aghasalim/smart-ivc-cage-platform/docs/architecture-overview.pdf

# IVC Cage — Technical Architecture

How the components connect: Cage hardware → Arduino Mega → Raspberry Pi 5 (self-hosted) → Cloudflare Tunnel → Web dashboard

CAGE HARDWARE | MICROCONTROLLER | EDGE HOST — RASPBERRY PI 5 | CLOUD · USERS · CI

### SENSORS → Mega pins

HX711 ×3 — load cells
food D4/5 · water D6/7 · mouse D8/9

DHT11 temp/humidity — D3

YF-S401 water flow — D2 (int)

MH-Z19C CO₂ — UART Serial3

### ACTUATORS ← Mega pins

Food-gate servo — D11

Water pump (relay) — D12

Solenoid valve (relay) — D13

### USB → PI (not via Mega)

O₂ sensor JXW-02
USB-CH340 → /dev/ttyUSB

USB cameras ×3
powered hub → V4L2 (MJPEG)

12 V supply → pump/valve;

### 5 V → Mega & sensors

## Arduino Mega

2560

reads all sensors
drives actuators
closed-loop dosing
+ flow calibration
feeding-gate logic

JSON over USB serial
115200 baud · every 5 s

## systemd services (no Docker) — hosts the whole stack

### ivc-arduino-bridge

USB serial ↔ Arduino · threaded poster · relays commands

### ivc-backend — FastAPI (:8000)

REST API + WebSocket · serves the React SPA AI: behaviour classifier + anomaly detector feeding scheduler → opens/closes gate on time SQLite (WAL) — local DB

### ivc-cameras (:8090)

V4L2 → MJPEG streams · snapshots · 16 camera controls · relays servo/pump cmds to the bridge

ivc-env-ingester
DHT11 → backend

ivc-inference
on-Pi YOLO detector

cloudflared
outbound tunnel
(no inbound ports)

pi-deploy.timer
polls GitHub 60 s →
rebuild + restart

Ingest: bridge → POST /api/v1/ingest → SQLite → WebSocket fan-out Commands: dashboard → backend/cameras → /tmp queue → bridge → Arduino

USB JSON

### Cloudflare

Tunnel + DNS/TLS
favatis.com · cam.favatis.com

### Web dashboard

React + Vite SPA
8 sections · 4 languages
live charts · camera control researcher in any browser / PWA

### GitHub repo

push to main →
auto-deploy to Pi

Google Colab
YOLO training (optional)

encrypted outbound

HTTPS / WSS

git push → 60 s poll → rebuild & restart

### Data & control flows

Sensors → Arduino (analog/digital/UART) and Arduino → actuators

Arduino ↔ Pi bridge over USB serial (JSON readings up; servo/pump/dose commands down)

USB sensors/cameras → Pi · and Pi ↔ browser via Cloudflare (HTTPS REST + live WebSocket)

Deploy loop: GitHub push → pi-deploy pulls every 60 s → rebuilds & restarts only changed services

Self-hosted on the Raspberry Pi 5 · exposed only through an outbound Cloudflare Tunnel (zero open inbound ports) · no Vercel/Railway.
