aghasalim/smart-ivc-cage-platform/ai/reports/behavioral_monitoring/outputs/plots/activity_rhythm.png

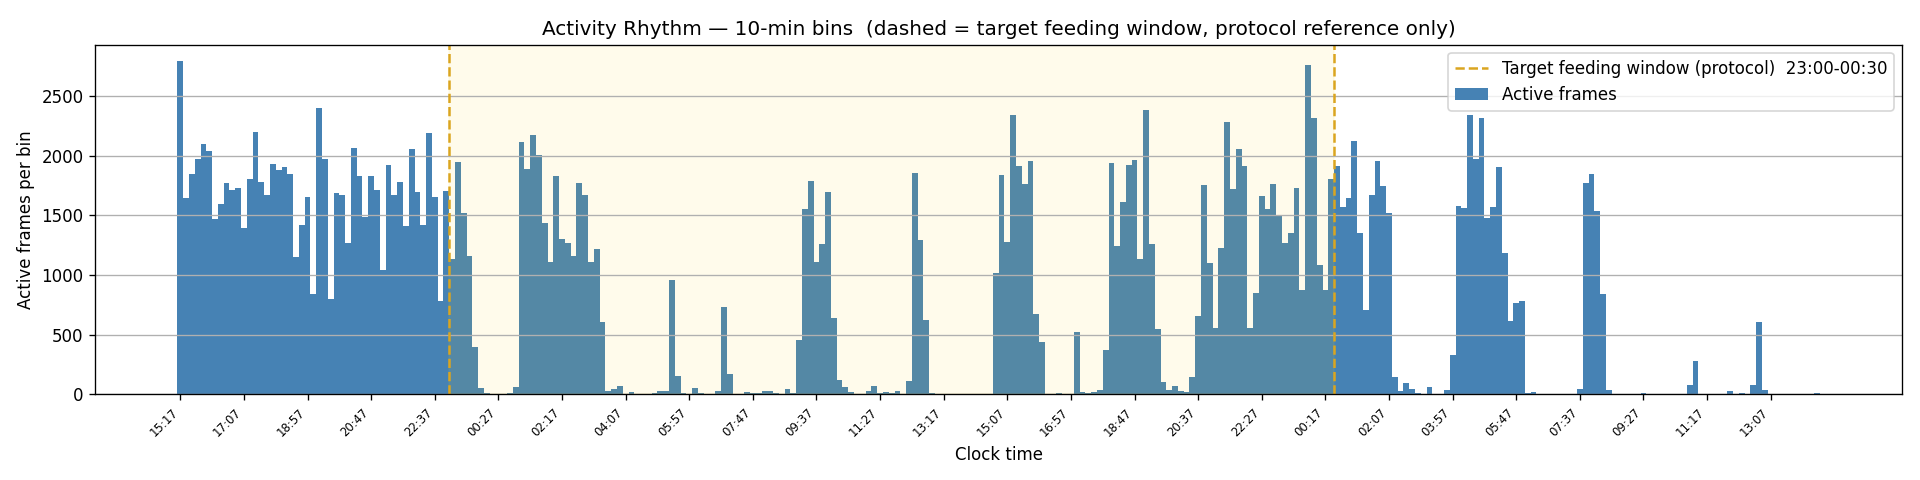
ai/reports/behavioral_monitoring/outputs/plots/activity_rhythm.png
