aghasalim/smart-ivc-cage-platform/ai/reports/behavioral_monitoring/outputs/plots/classification_report_comparison.png

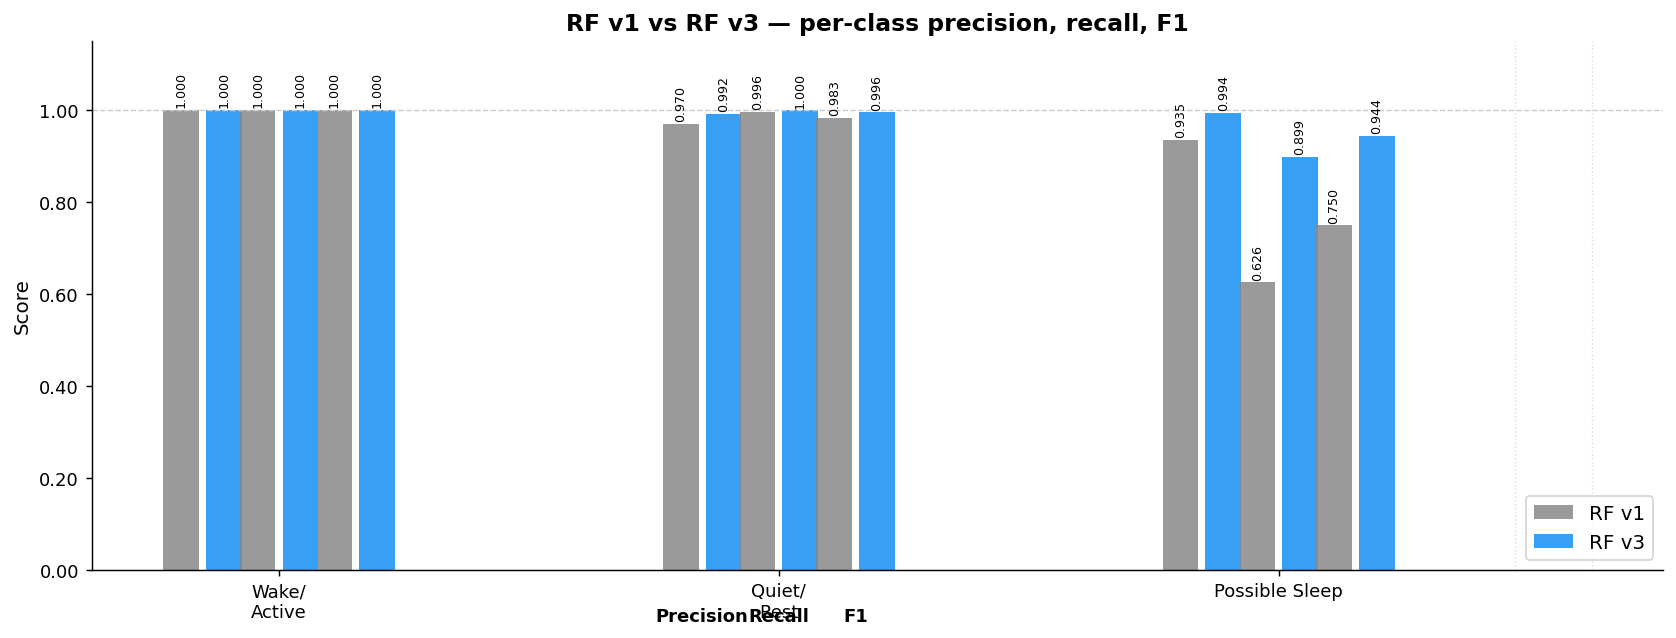
ai/reports/behavioral_monitoring/outputs/plots/classification_report_comparison.png
