aghasalim/smart-ivc-cage-platform/ai/reports/behavioral_monitoring/outputs/plots/confusion_matrix_comparison.png

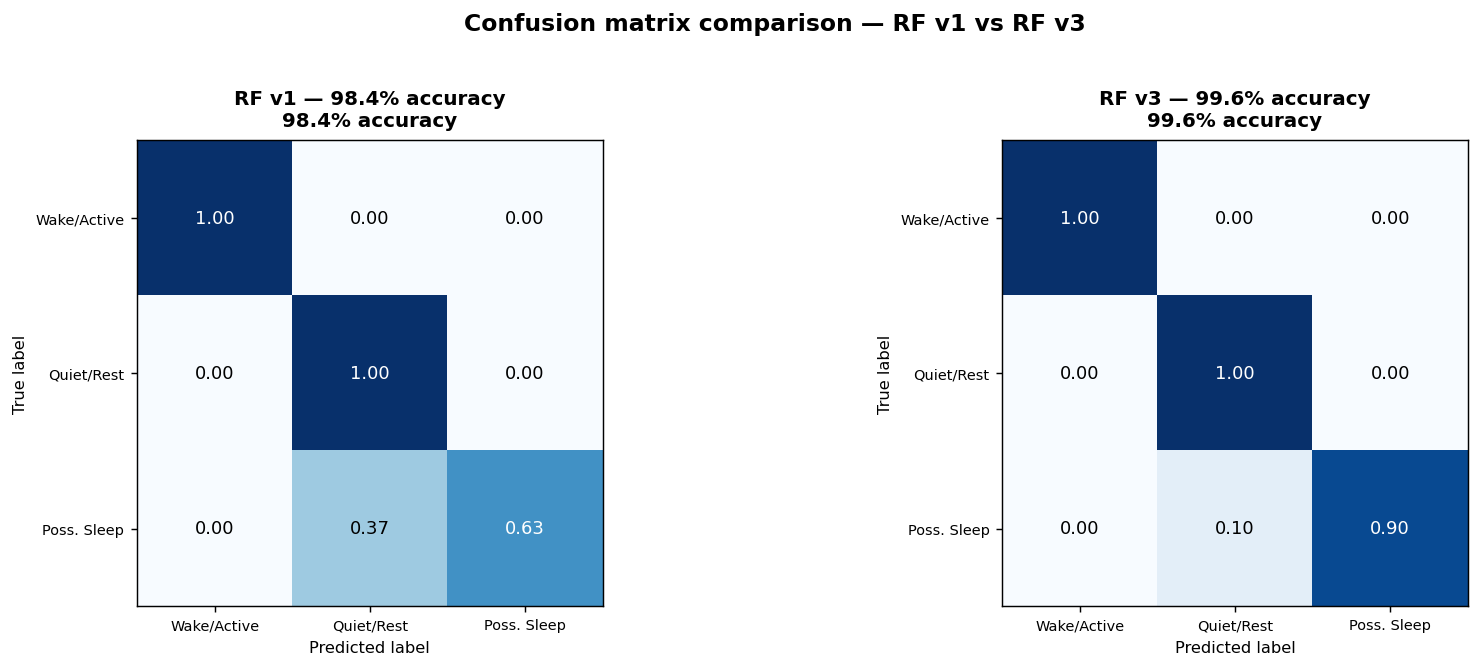
ai/reports/behavioral_monitoring/outputs/plots/confusion_matrix_comparison.png
