aghasalim/smart-ivc-cage-platform/ai/reports/behavioral_monitoring/outputs/plots/confusion_matrix_rf_v1.png

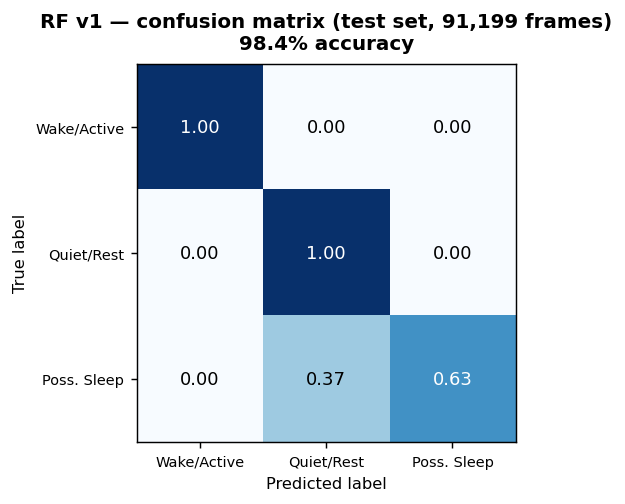
ai/reports/behavioral_monitoring/outputs/plots/confusion_matrix_rf_v1.png
