aghasalim/smart-ivc-cage-platform/ai/reports/behavioral_monitoring/outputs/plots/confusion_matrix_rf_v3.png

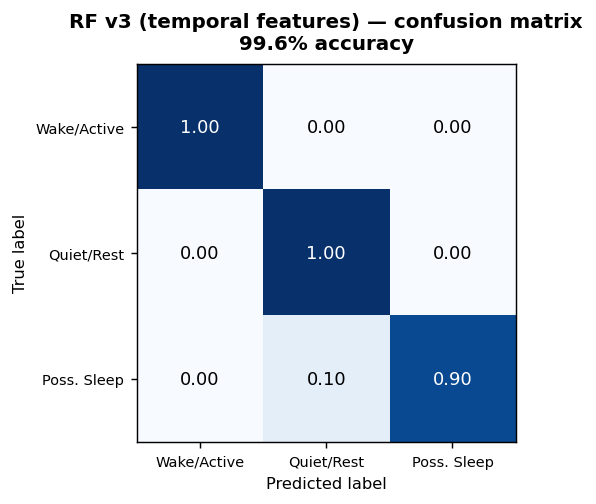
ai/reports/behavioral_monitoring/outputs/plots/confusion_matrix_rf_v3.png
