aghasalim/smart-ivc-cage-platform/ai/reports/behavioral_monitoring/outputs/plots/motion_diagnostic.png

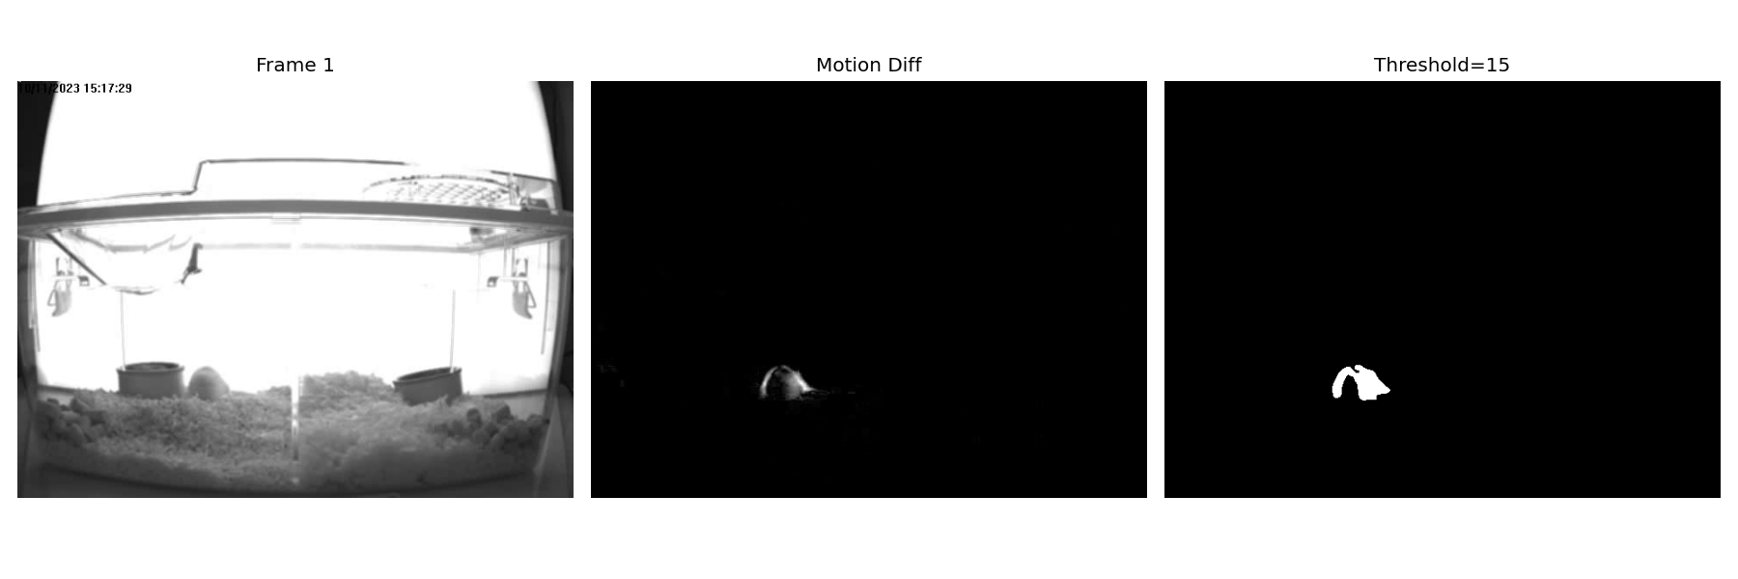
ai/reports/behavioral_monitoring/outputs/plots/motion_diagnostic.png
