aghasalim/smart-ivc-cage-platform/ai/reports/behavioral_monitoring/outputs/plots/movement_smooth.png

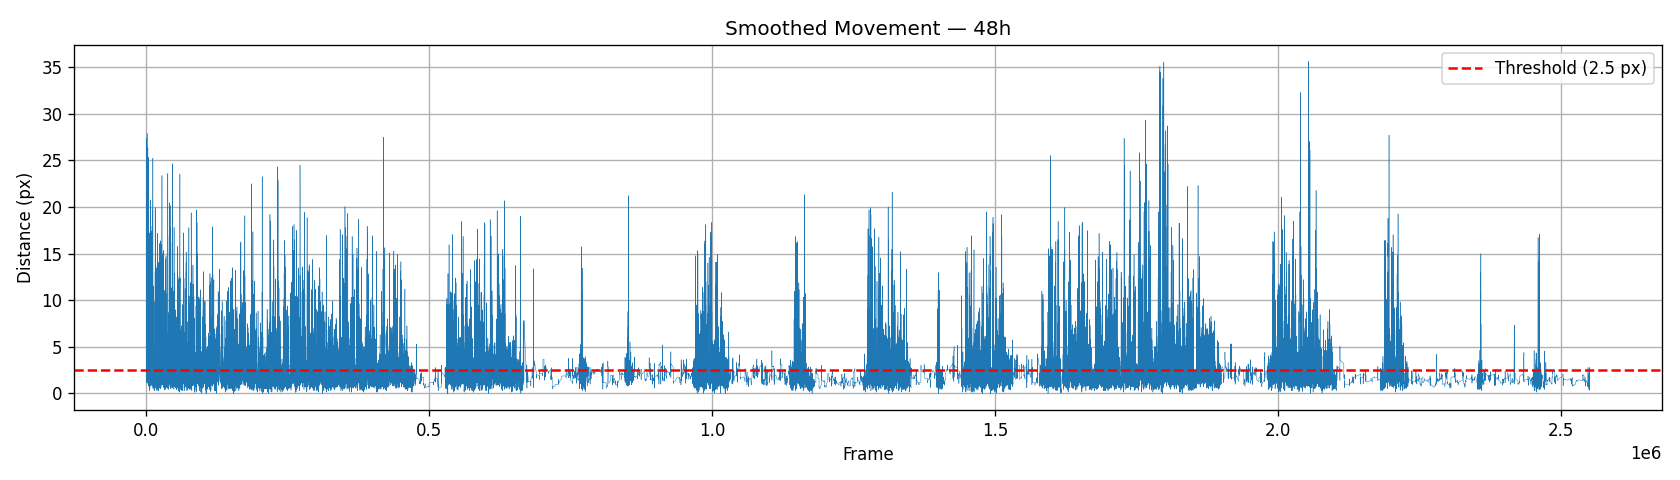
ai/reports/behavioral_monitoring/outputs/plots/movement_smooth.png
