aghasalim/smart-ivc-cage-platform/ai/reports/behavioral_monitoring/outputs/plots/possible_sleep_improvement.png

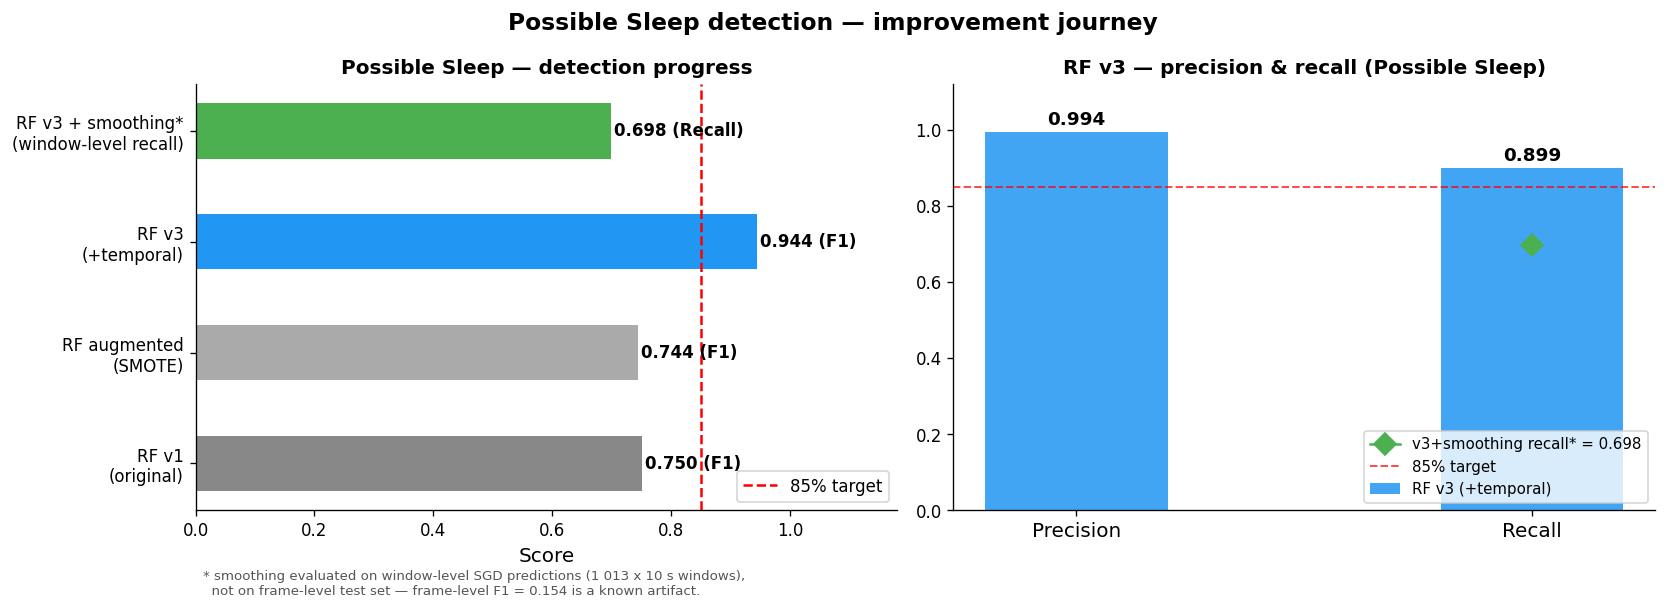
ai/reports/behavioral_monitoring/outputs/plots/possible_sleep_improvement.png
