aghasalim/smart-ivc-cage-platform/ai/reports/behavioral_monitoring/outputs/plots/sgd_agreement_over_time.png

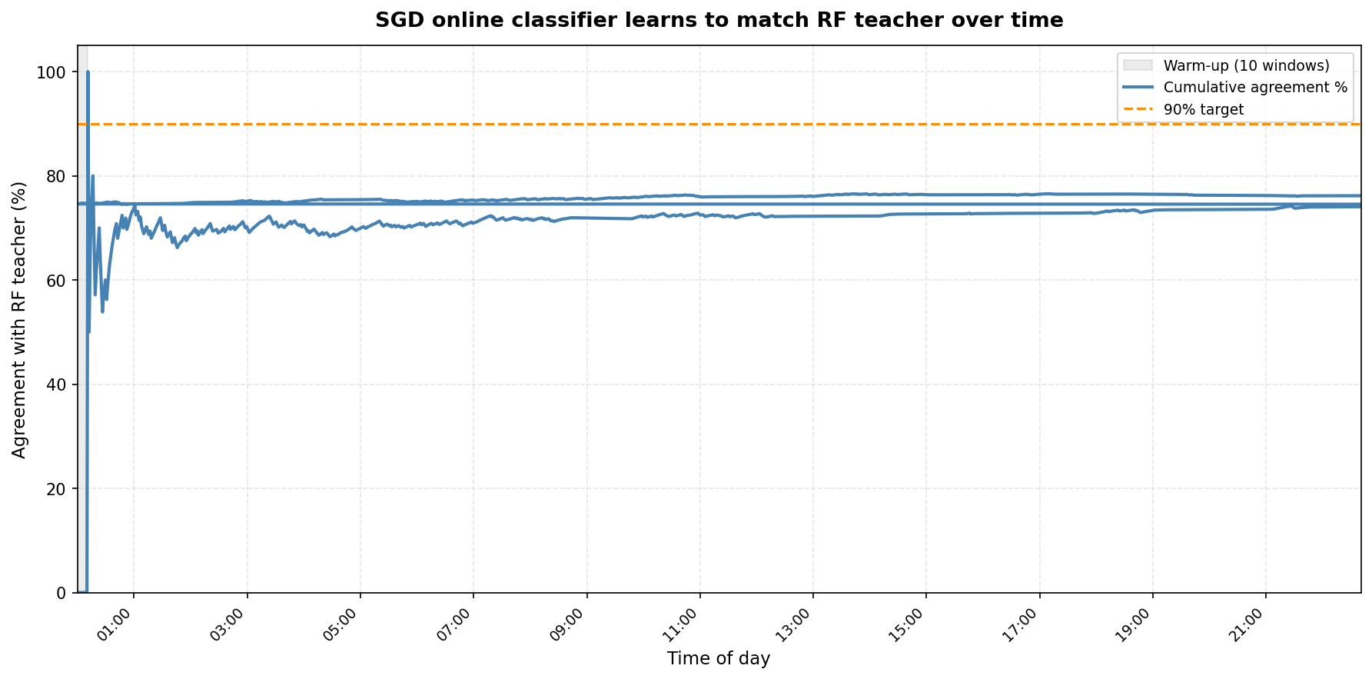
ai/reports/behavioral_monitoring/outputs/plots/sgd_agreement_over_time.png
