aghasalim/smart-ivc-cage-platform/ai/reports/behavioral_monitoring/outputs/plots/sgd_comparison.png

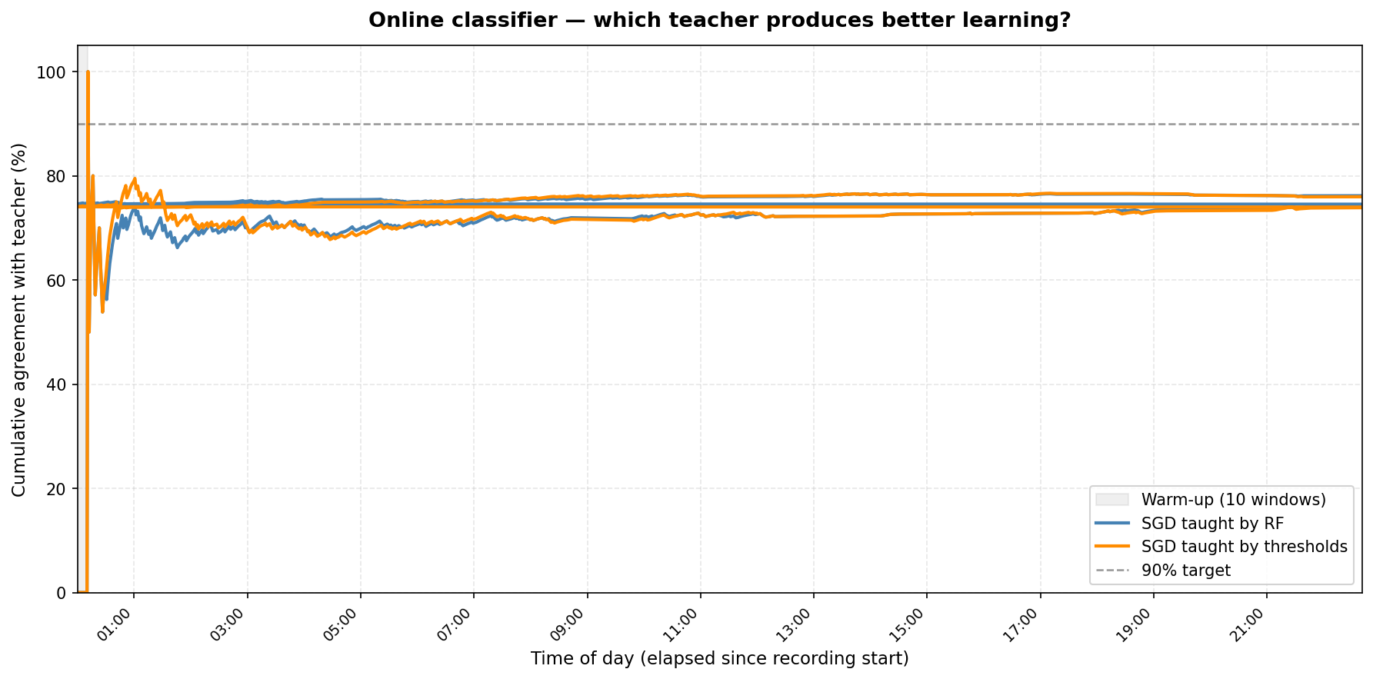
ai/reports/behavioral_monitoring/outputs/plots/sgd_comparison.png
