aghasalim/smart-ivc-cage-platform/ai/reports/behavioral_monitoring/outputs/plots/sgd_comparison_final.png

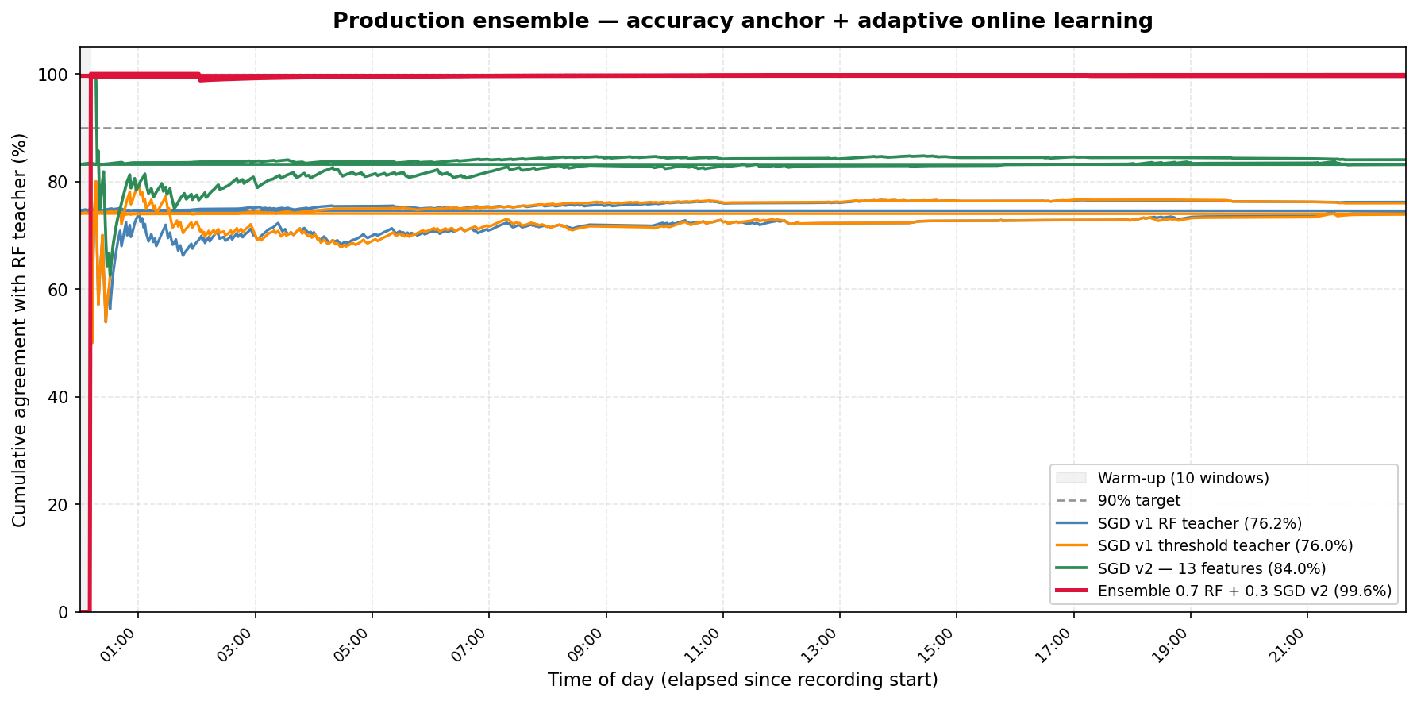
ai/reports/behavioral_monitoring/outputs/plots/sgd_comparison_final.png
