aghasalim/smart-ivc-cage-platform/ai/reports/behavioral_monitoring/outputs/plots/sgd_comparison_v2.png

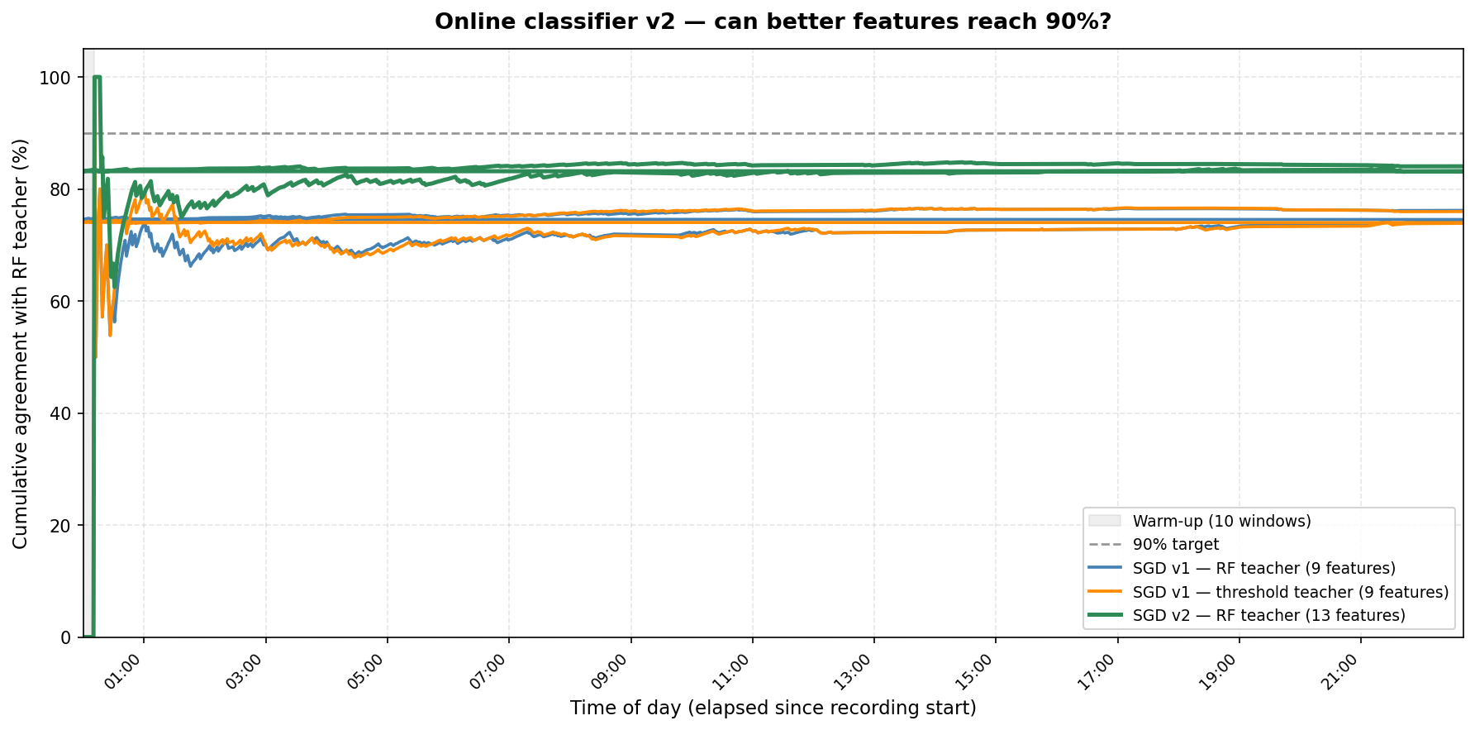
ai/reports/behavioral_monitoring/outputs/plots/sgd_comparison_v2.png
