aghasalim/smart-ivc-cage-platform/ai/reports/behavioral_monitoring/outputs/plots/sgd_confidence_over_time.png

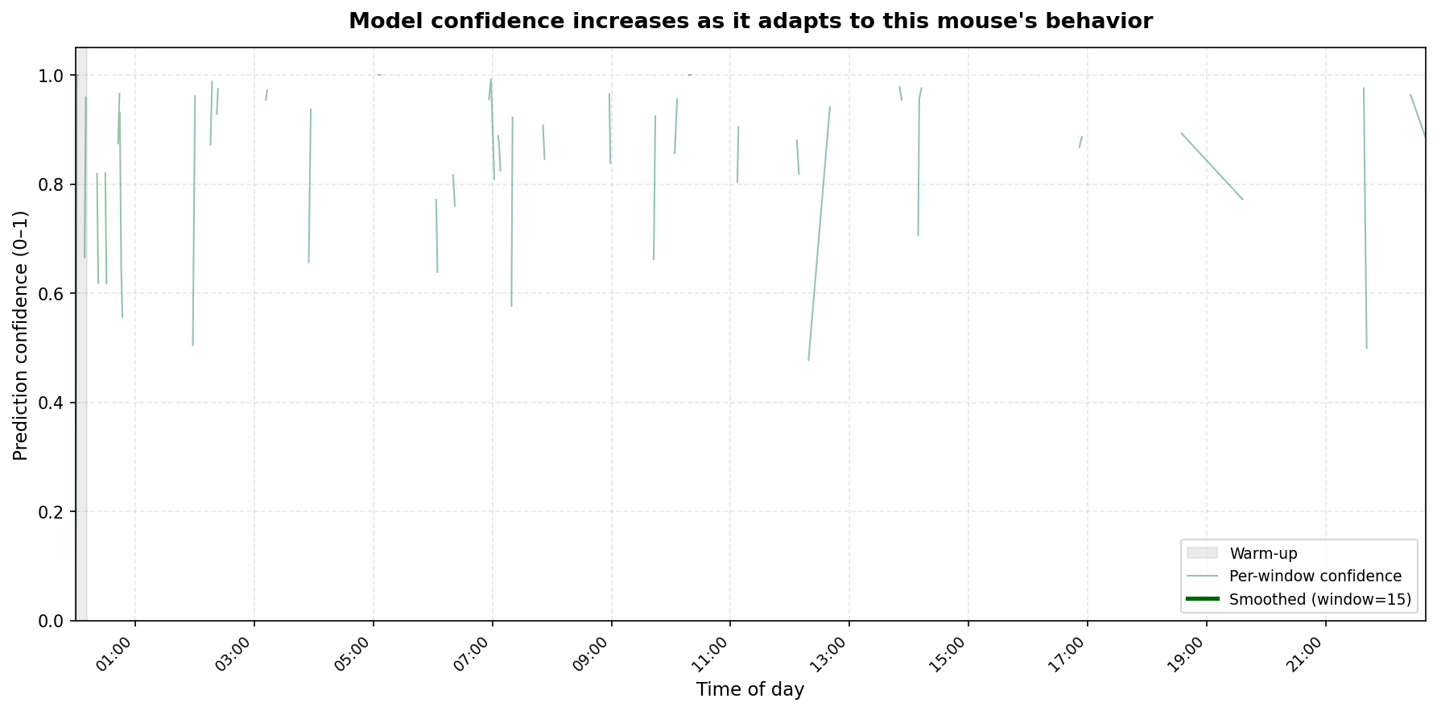
ai/reports/behavioral_monitoring/outputs/plots/sgd_confidence_over_time.png
