aghasalim/smart-ivc-cage-platform/ai/reports/behavioral_monitoring/outputs/plots/sleep_wake.png

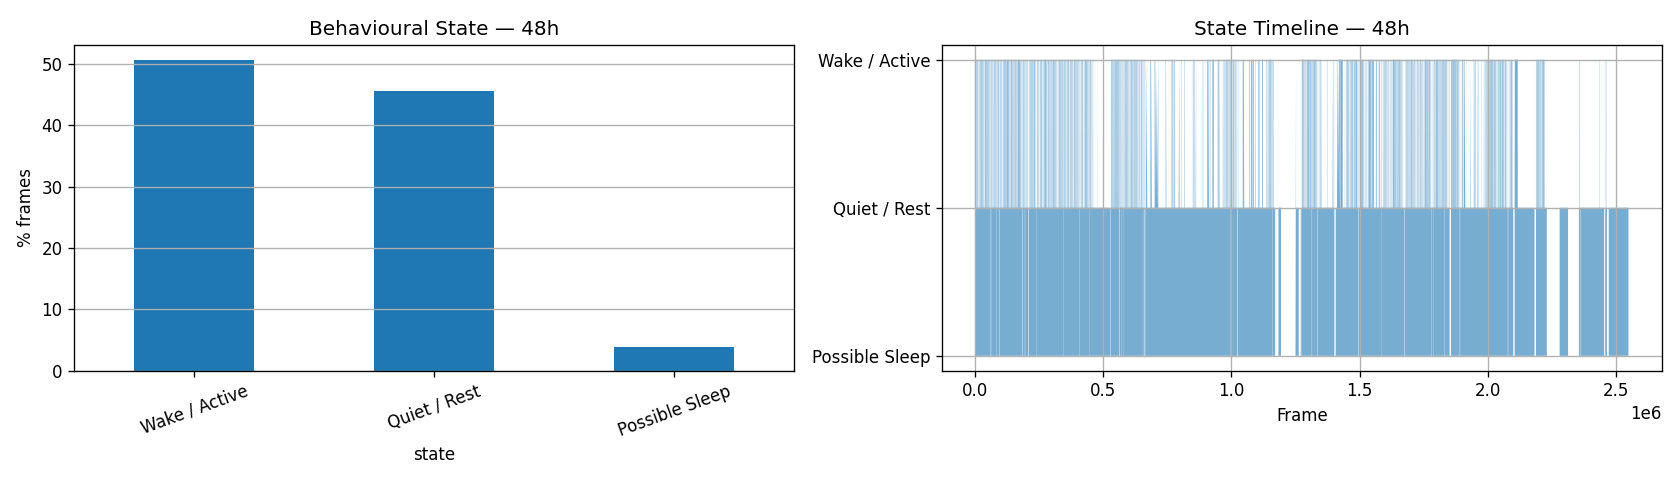
ai/reports/behavioral_monitoring/outputs/plots/sleep_wake.png
