aghasalim/smart-ivc-cage-platform/ai/reports/behavioral_monitoring/outputs/plots/stereotypy.png

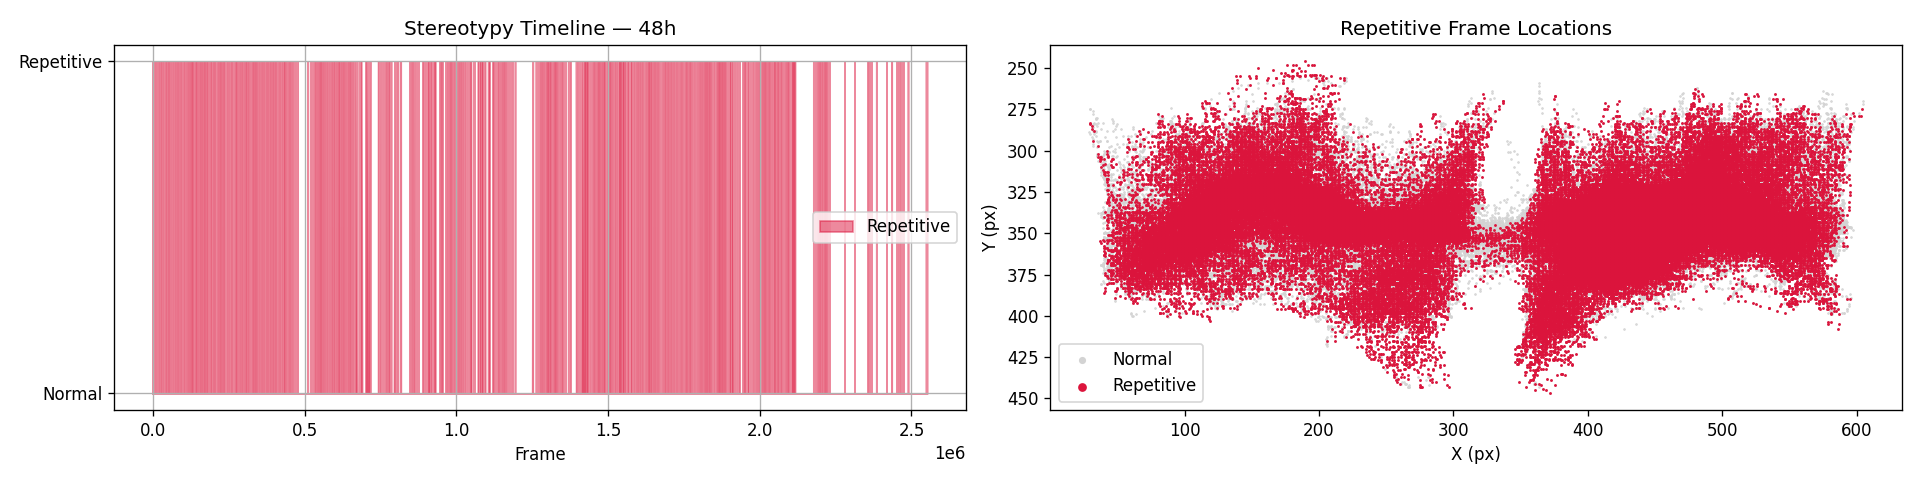
ai/reports/behavioral_monitoring/outputs/plots/stereotypy.png
