aghasalim/smart-ivc-cage-platform/ai/reports/behavioral_monitoring/outputs/plots/threshold_sweep.png

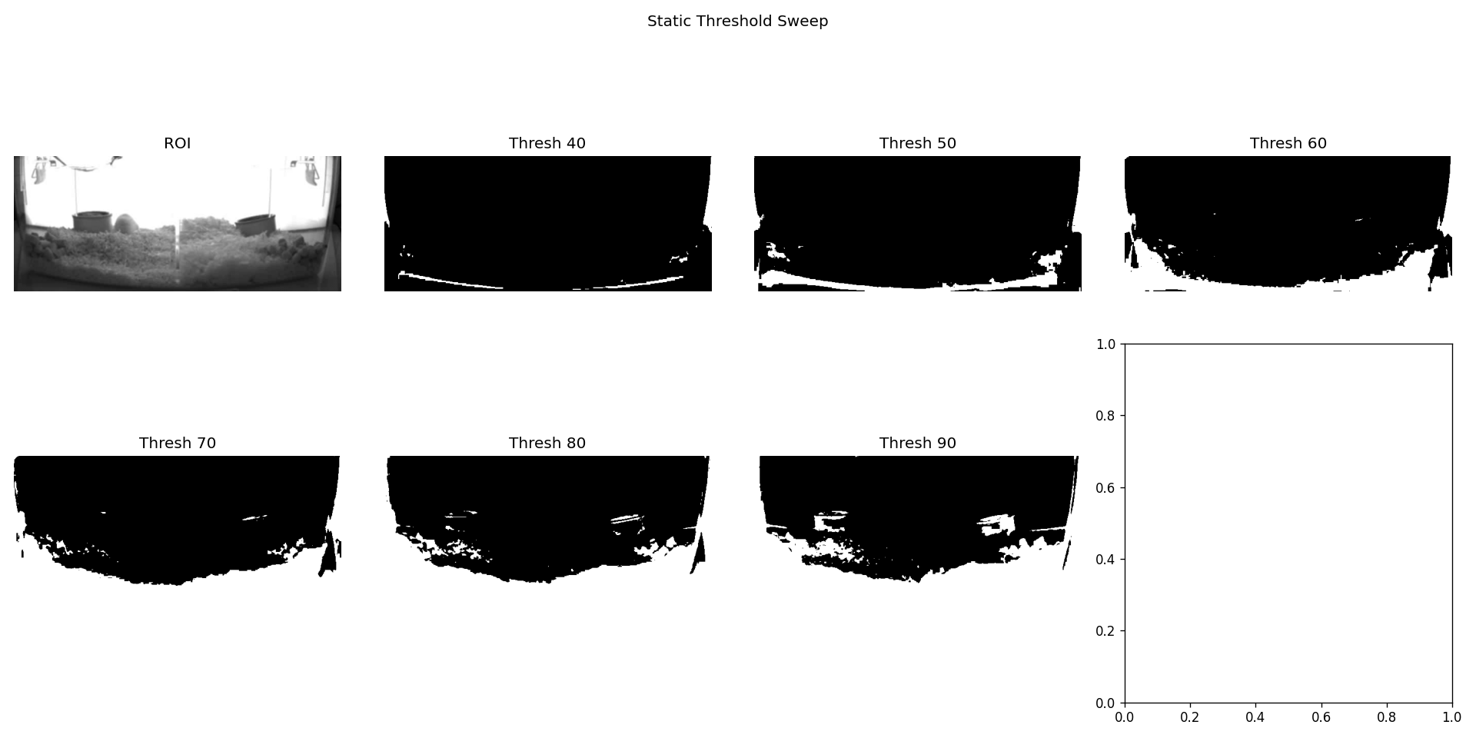
ai/reports/behavioral_monitoring/outputs/plots/threshold_sweep.png
