aghasalim/smart-ivc-cage-platform/ai/reports/behavioral_monitoring/outputs/plots/trajectory_raw.png

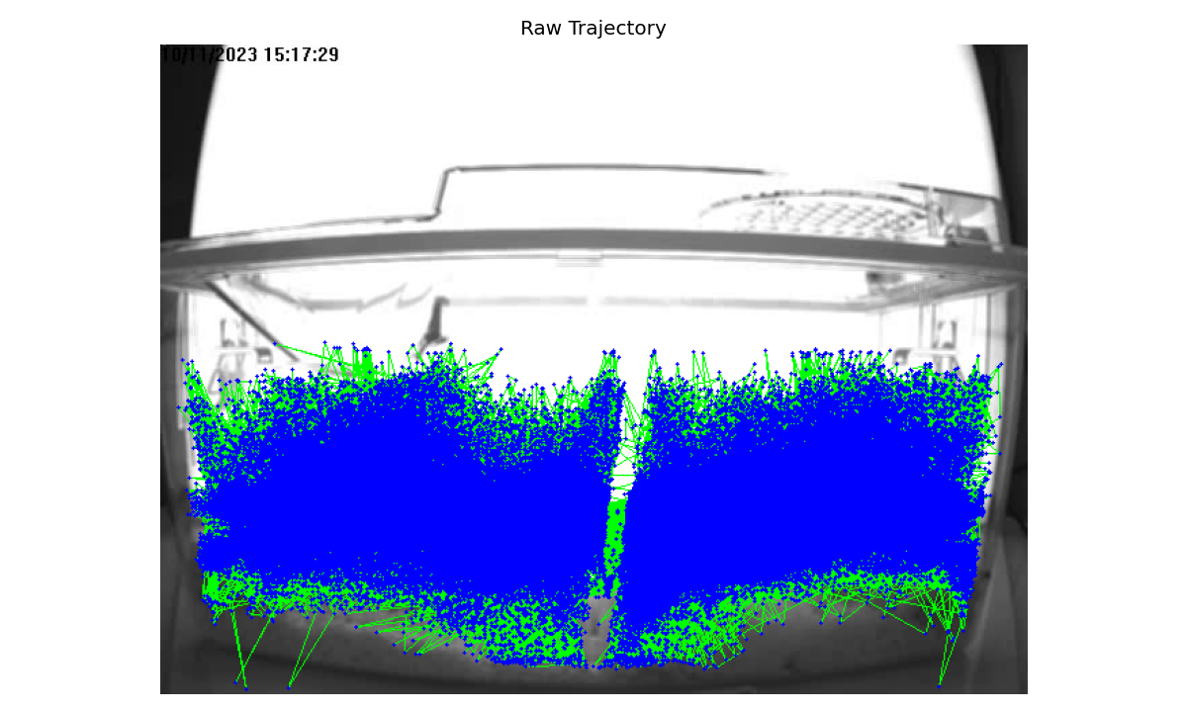
ai/reports/behavioral_monitoring/outputs/plots/trajectory_raw.png
