aghasalim/smart-ivc-cage-platform/ai/reports/behavioral_monitoring/outputs/plots/zone_analysis.png

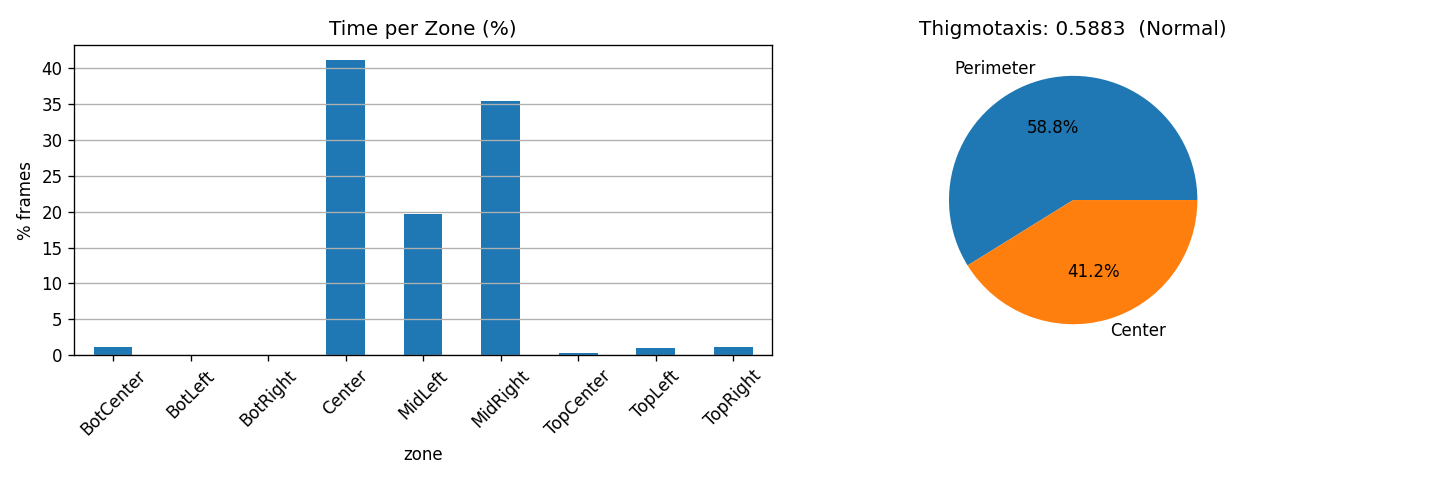
ai/reports/behavioral_monitoring/outputs/plots/zone_analysis.png
