aghasalim/smart-ivc-cage-platform/ai/reports/behavioral_monitoring/outputs/plots/zone_grid.png

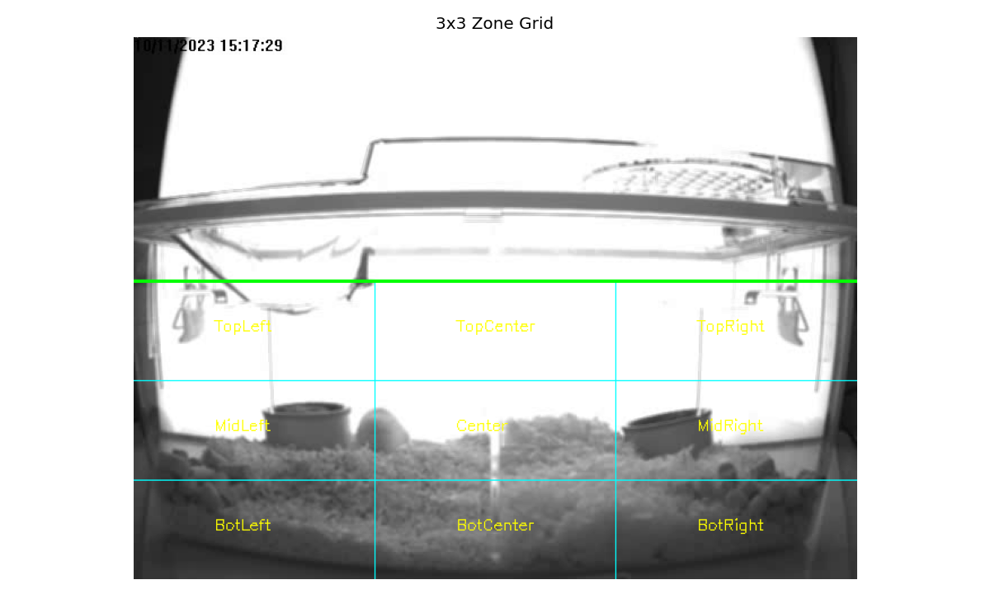
ai/reports/behavioral_monitoring/outputs/plots/zone_grid.png
