aghasalim/smart-ivc-cage-platform/ai/reports/multi_animal_tracking/outputs/plots/group_social_timeline.png

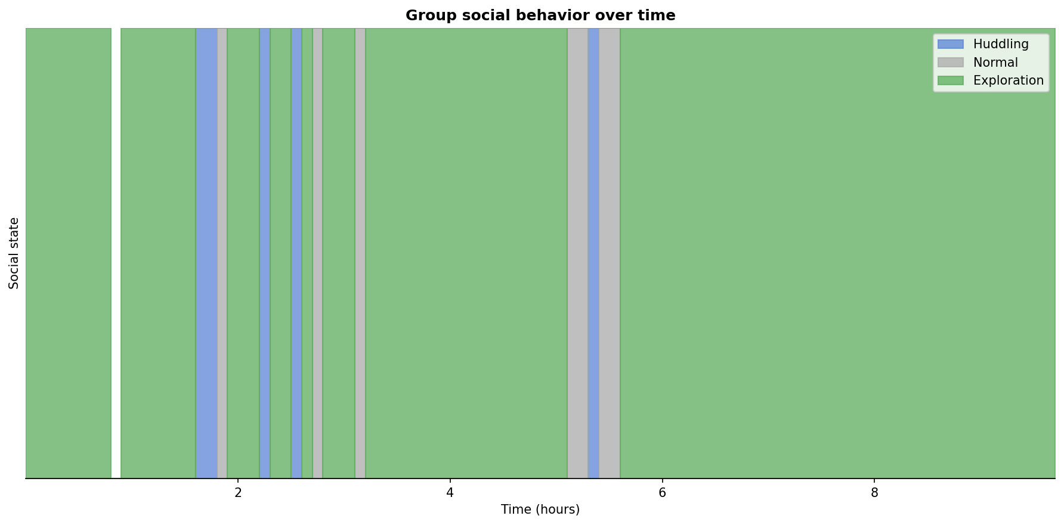
ai/reports/multi_animal_tracking/outputs/plots/group_social_timeline.png
