aghasalim/smart-ivc-cage-platform/ai/reports/multi_animal_tracking/outputs/plots/interanimal_distance_9h.png

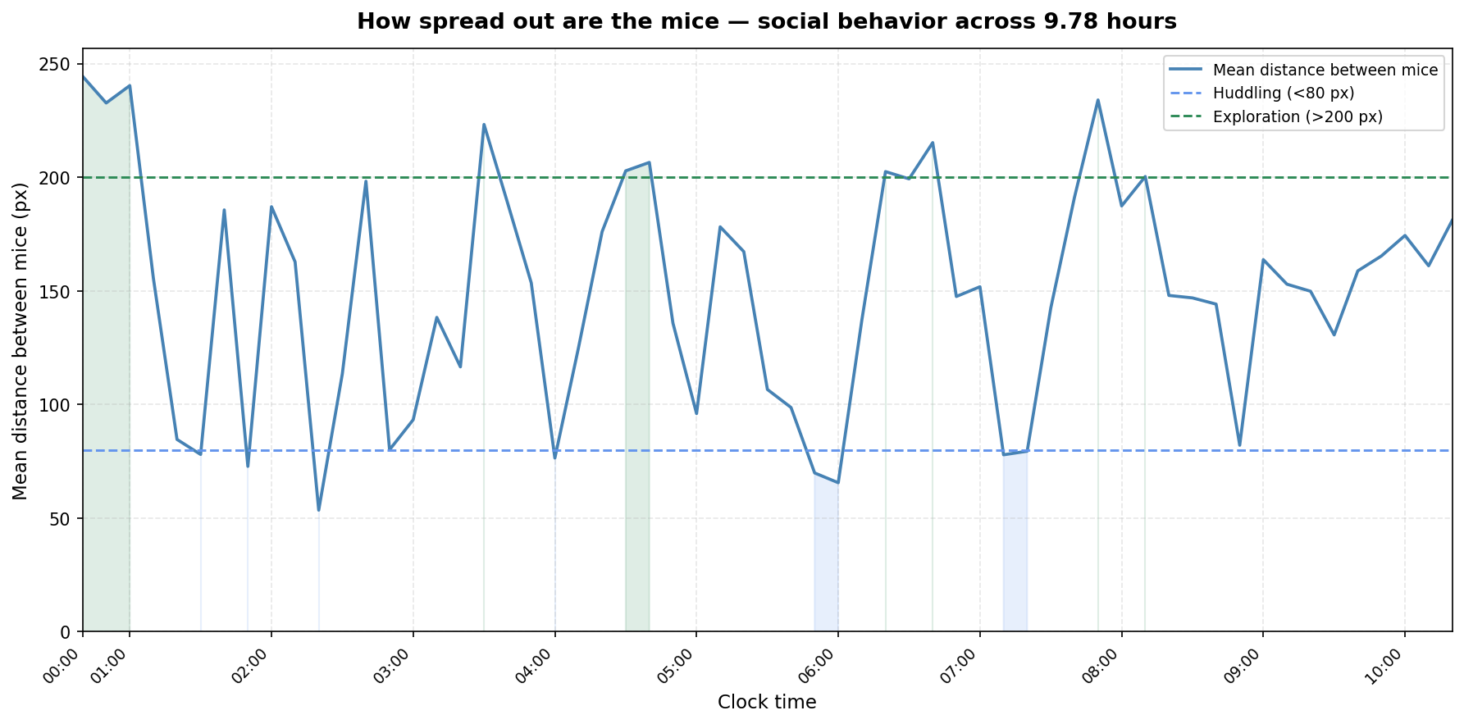
ai/reports/multi_animal_tracking/outputs/plots/interanimal_distance_9h.png
