aghasalim/smart-ivc-cage-platform/ai/reports/multi_animal_tracking/outputs/plots/per_mouse_activity.png

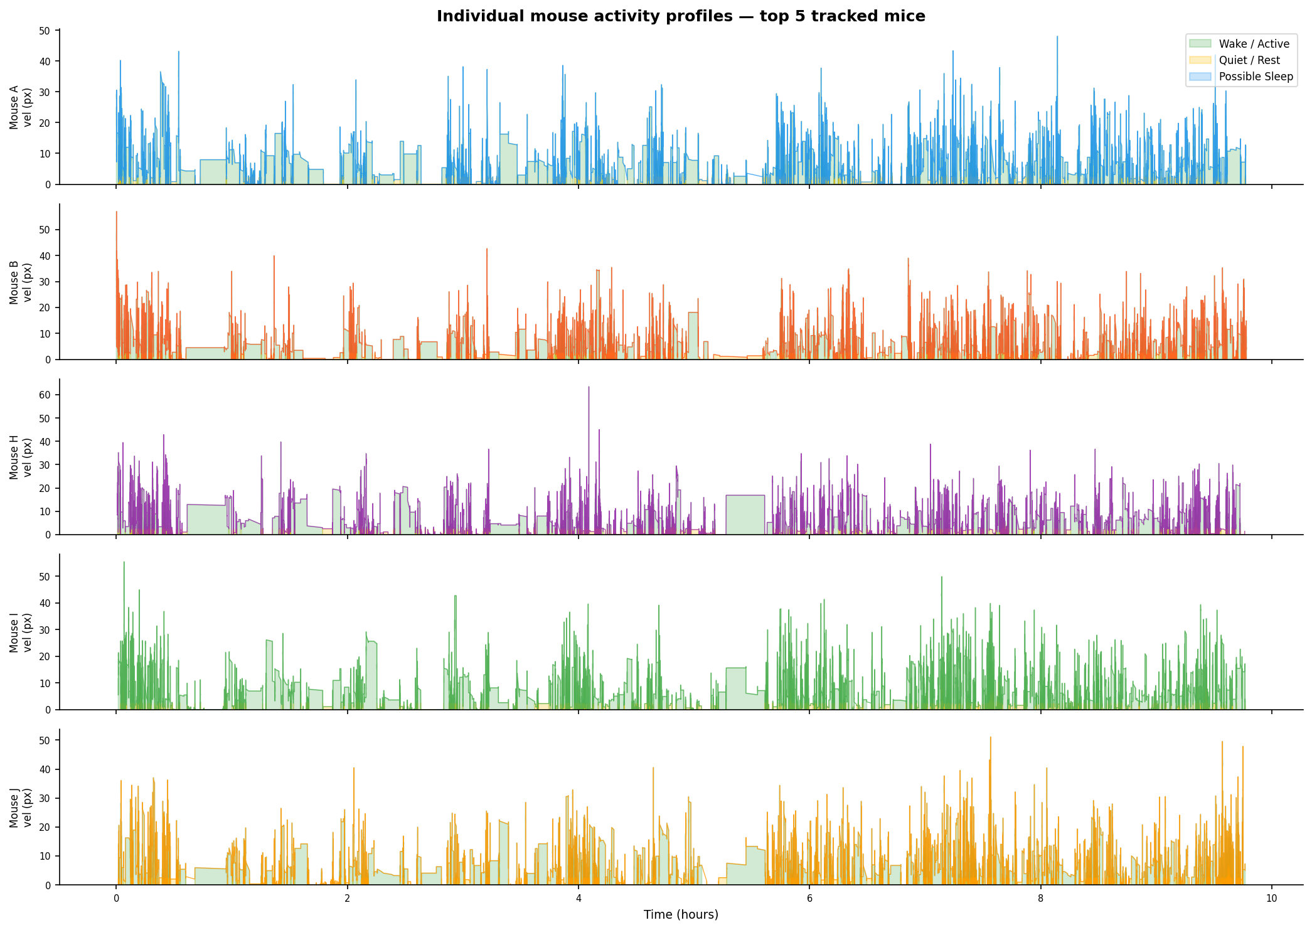
ai/reports/multi_animal_tracking/outputs/plots/per_mouse_activity.png
