aghasalim/smart-ivc-cage-platform/ai/reports/multi_animal_tracking/outputs/plots/rf_vs_threshold_multi_mouse.png

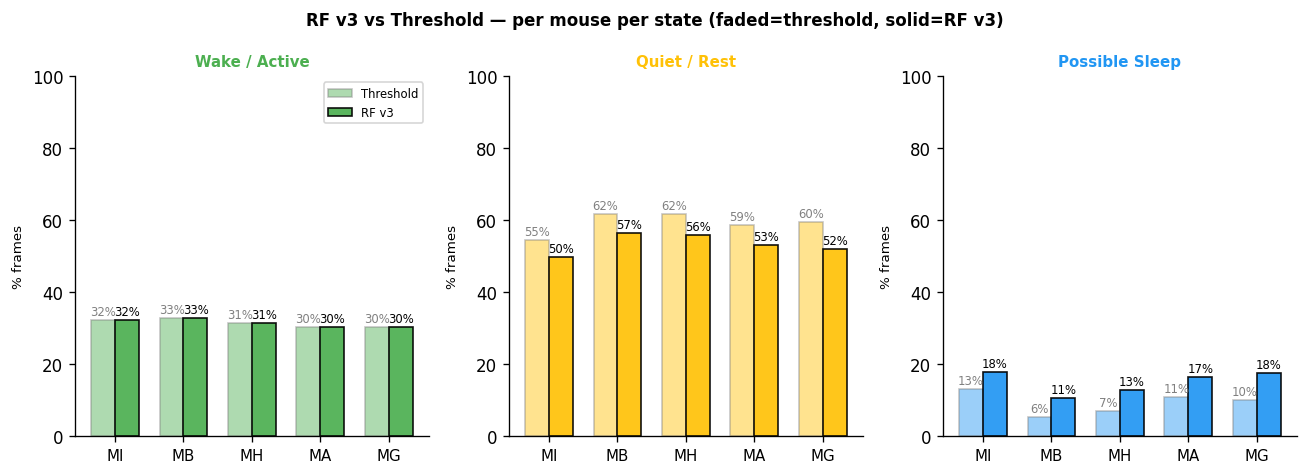
ai/reports/multi_animal_tracking/outputs/plots/rf_vs_threshold_multi_mouse.png
