aghasalim/smart-ivc-cage-platform/ai/reports/multi_animal_tracking/outputs/plots/social_behavior_distribution.png

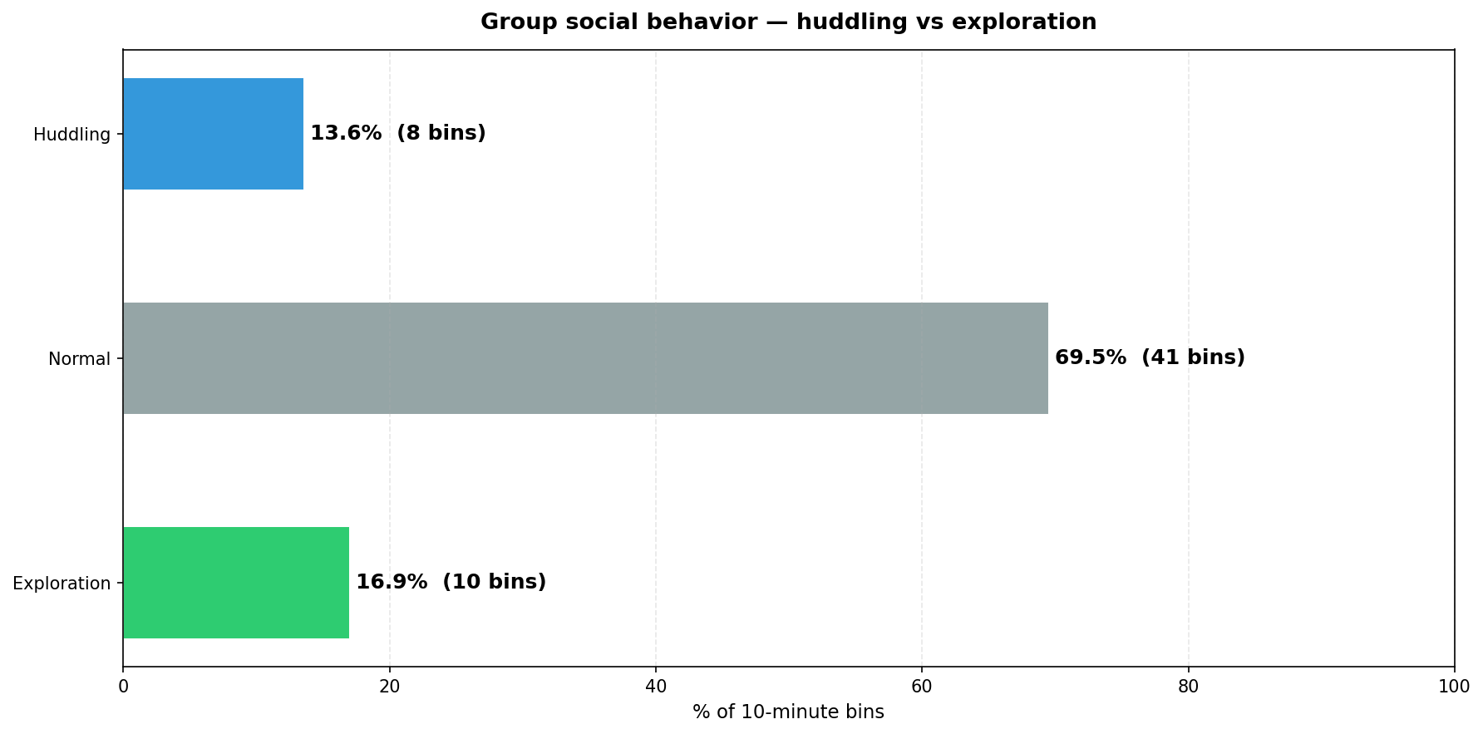
ai/reports/multi_animal_tracking/outputs/plots/social_behavior_distribution.png
