aghasalim/smart-ivc-cage-platform/ai/reports/multi_animal_tracking/outputs/plots/social_classifier_confusion.png

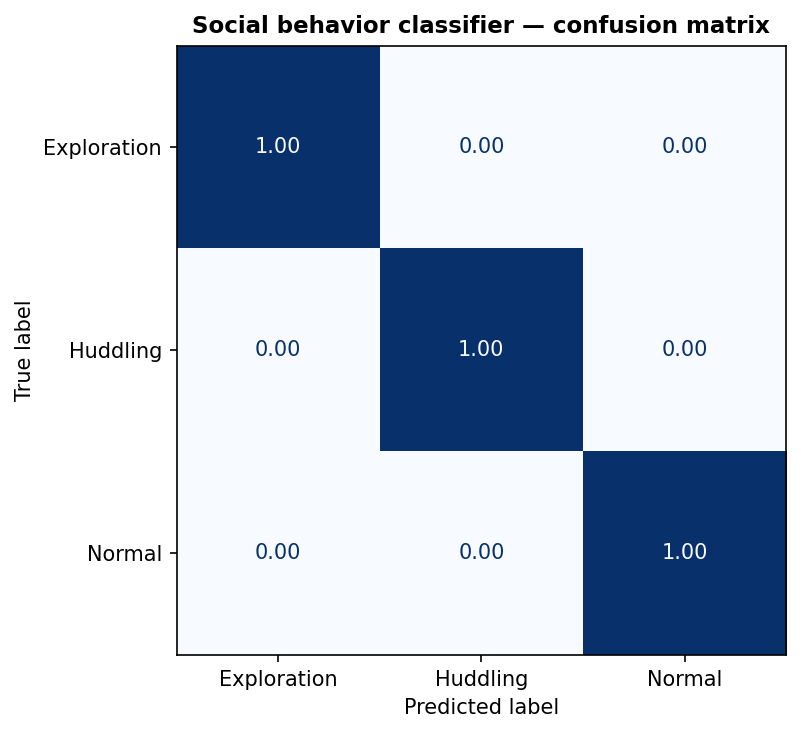
ai/reports/multi_animal_tracking/outputs/plots/social_classifier_confusion.png
