aghasalim/smart-ivc-cage-platform/device/mouse-reservoir/mouse_lid.stl

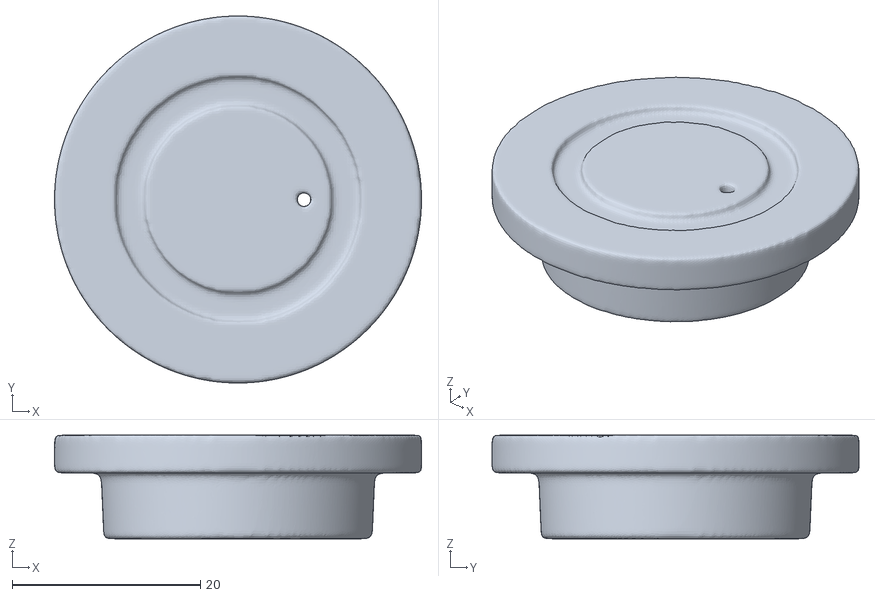
[picture p48: CAD file, 2026-10-29]
device/mouse-reservoir/mouse_lid.stl
39.0 x 39.0 x 11.0
