aghasalim/smart-ivc-cage-platform/device/mouse-reservoir/mouse_reservoir_body.stl

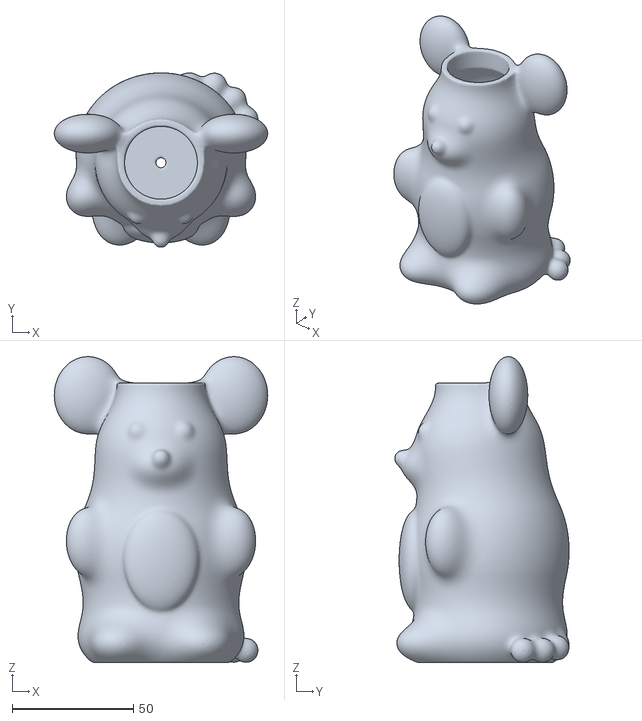
[picture p49: CAD file, 2026-10-29]
device/mouse-reservoir/mouse_reservoir_body.stl
87.9 x 71.7 x 126.0
