aghasalim/smart-ivc-cage-platform/ai/reports/RESULTS.md

# Results

Generated by `ai/reports/results_table.py` from `metrics.json`; don't edit by hand.
All figures are on the synthetic set (`ai/data/DATASET.md`), so read them as
'how separable the generator made its classes', not as accuracy on a mouse.

## Production model

| | |
|---|---|
| Model | HistGradientBoostingClassifier (max_iter 400, lr 0.06, depth 8) |
| Data | `ai/data/synthetic.csv`, generator seed 42 |
| Split | stratified by row, seed 42 |
| Rows | train 14,450 / val 2,550 / test 3,000 |
| Val macro-F1 | 0.9953 |
| Test macro-F1 | 0.9957 |
| Test accuracy | 0.9950 |
| Written | 2026-10-29, commit `4569aa8` |

## Per class (test split)

| Class | Precision | Recall | F1 | Support |
|---|---:|---:|---:|---:|
| active | 0.999 | 0.998 | 0.999 | 1146 |
| drinking | 0.994 | 1.000 | 0.997 | 159 |
| eating | 1.000 | 1.000 | 1.000 | 100 |
| exploring | 0.998 | 0.998 | 0.998 | 474 |
| resting | 0.998 | 0.978 | 0.988 | 503 |
| sleeping | 0.980 | 0.998 | 0.989 | 532 |
| stereotyped | 1.000 | 1.000 | 1.000 | 86 |

## Confusion matrix (rows = true, columns = predicted)

| | active | drinking | eating | exploring | resting | sleeping | stereotyped |
|---|---:|---:|---:|---:|---:|---:|---:|
| **active** | 1144 | 1 | 0 | 1 | 0 | 0 | 0 |
| **drinking** | 0 | 159 | 0 | 0 | 0 | 0 | 0 |
| **eating** | 0 | 0 | 100 | 0 | 0 | 0 | 0 |
| **exploring** | 1 | 0 | 0 | 473 | 0 | 0 | 0 |
| **resting** | 0 | 0 | 0 | 0 | 492 | 11 | 0 |
| **sleeping** | 0 | 0 | 0 | 0 | 1 | 531 | 0 |
| **stereotyped** | 0 | 0 | 0 | 0 | 0 | 0 | 86 |

## Model comparison (`compare_models.py`, 80/20 split, seed 0)

| Model | Macro-F1 |
|---|---:|
| `random_forest` | 0.996 |
| `hist_gradient_boosting` | 0.996 |
| `logistic_regression` | 0.935 |

## Reproduce

```bash
make train     # ~1 min on a laptop; rewrites metrics.json and this file
make verify    # recomputes the numbers above in eight languages
```
