aghasalim/smart-ivc-cage-platform/(commit log)

2026-08-14 Smart IVC cage software platform (sanitised public extract)
    Full stack for an instrumented individually ventilated cage used in laboratory
    animal research: FastAPI backend, React dashboard, Arduino Mega firmware,
    Raspberry Pi device services, camera streaming, and a pull-only auto-deploy
    pipeline behind a Cloudflare Tunnel with no inbound ports.
    Published with fresh history rather than a fork. The original repository is a
    three-person university Industry Project; its 204 commits carry teammates'
    addresses and whatever was committed and later removed, none of which belongs in
    a public portfolio extract.
    Removed before publishing: the client's name and email address, five client and
    coach me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
    [behavior_summary.csv, ensemble_learning_log.csv, group_summary.csv, realtime_summary.csv, sgd_learning_log.csv, sgd_threshold_learning_log.csv, sgd_v2_learning_log.csv, synthetic.csv]
2026-08-24 Add an architecture diagram and the figure behind the F1 caveat
    The ASCII architecture block becomes a Mermaid flowchart, which GitHub renders
    inline and which stays diffable. Dropped the paragraph underneath it that now
    just restated the picture.
    The new figure supports the section that refuses to advertise macro-F1 0.996.
    The generator writes each behaviour as its own band of movement_cm -- sleeping
    never exceeds 0.3 cm, exploring starts at 6.0 -- and an unpruned decision tree
    on those features scores 0.9936, within 0.003 of the reported random forest.
    That makes the argument concrete: the classifier recovers the rules the
    generator wrote and says nothing about a real mouse.
    ai/reports/m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
2026-08-24 Add three more AI figures
    The synthetic-separability figure covered why the headline F1 is meaningless.
    These cover the part of the stack that is not synthetic.
    - behaviour-timeline: 284 windows of real camera output from the rig, with
    thigmotaxis tracked alongside movement since either alone is ambiguous
    - online-agreement: the SGD variants against the fixed random forest over a
    session, which is the operational question -- whether the model on the Pi
    stays close to the one validated offline
    - confusion: the test-split confusion matrix, captioned to be read against the
    separability figure rather than on its own
    make_figures.py needed a json import it did not have.
2026-08-27 Add references
    Short lists, because these are engineering projects rather than implementations
    of published methods, and the sections say so rather than padding.
    The drone cites momentum theory, which is the actual reason a larger rotor at
    lower RPM buys endurance, plus the component datasheets the powertrain figures
    come from. The cage cites Directive 2010/63/EU, the regime any live animal work
    would fall under and the one this project explicitly stayed outside of, and the
    paper behind the median absolute deviation rule its anomaly detector uses.
    Every link was checked. No EASA drone regulation is cited because the repo does
    not discuss airspace or licensing, and a citation for something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
2026-09-27 Scrub personal details and make the docs match the code
    Scrub: the Pi's direct-cable address, a teammate's login and Windows paths, the
    original repository URL, a production hostname and a personal e-mail are replaced
    with generic values (raspberrypi.local, a pi user, env-var paths, this repo, a
    GitHub security-advisory contact).
    Docs vs code:
    - dosing runs open-loop at a scale-calibrated 4.5 mL/s: the flow sensor's
    electrical noise defeats the firmware's closed loop (README, METHODS, HARDWARE,
    GETTING_STARTED, BOM, the dashboard label and comments)
    - the datasheet DHT11 driver is in the earlier valve_controller sketch; the
    current sketch uses the DHT library
    - the 284 real windows ar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
    [server.py, system.py]
2026-09-27 Hardware note: the delivered Pi 5 has 8 GB and the unit kept its cameras
2026-10-10 Read naive SQLite timestamps as UTC in the state timeline
    SQLite returns the stored timestamps without a timezone, so ts.timestamp() in state_timeline treated them as local time while the day boundary is UTC. On a machine set to Europe/Brussels every ethogram segment moved by the local offset. Naive timestamps are now tagged as UTC before bucketing, and a test runs the endpoint under TZ=Europe/Brussels.
2026-10-25 Show the real hardware and dashboard in the README
    Add photos of the assembled cage, bench prototype, enclosure wiring,
    load cells and pump calibration, two dashboard screenshots taken
    against the simulator, and the existing IR frame and heatmap plots.
2026-10-29 Add mouse water reservoir STL models and paint guide
2026-10-29 Add build guide, training docs, examples and project hygiene
    - docs/BUILD_GUIDE.md: print, wire, flash, Pi, water, with a check per stage
    and a wiring diagram (docs/images/wiring-diagram.svg)
    - ai/data/DATASET.md data card; ai/reports/RESULTS.md generated from
    metrics.json by results_table.py; Colab notebook for the classifier
    - examples/: curl walkthrough, stdlib Python client, full ingest packet
    - docs/TROUBLESHOOTING.md, CONTRIBUTING.md, CHANGELOG.md, Makefile
    - README links to all of the above
2026-11-11 Credit PCBWay as PCB sponsor in the README
    PCBWay is covering fabrication and assembly of 10 boards for the cage.
    Adds their logo near the top and a "PCBs manufactured and assembled by
    PCBWay" section under the hardware, with the review points to fill in
    and a commented-out photo table for when the boards arrive.
